jnedbal/MicroFLiC_junction_shield_1_1/MicroFLiC_junction_shield.kicad_pcb

## KiCad design MicroFLiC_junction_shield.kicad_pcb (2016-07-07)

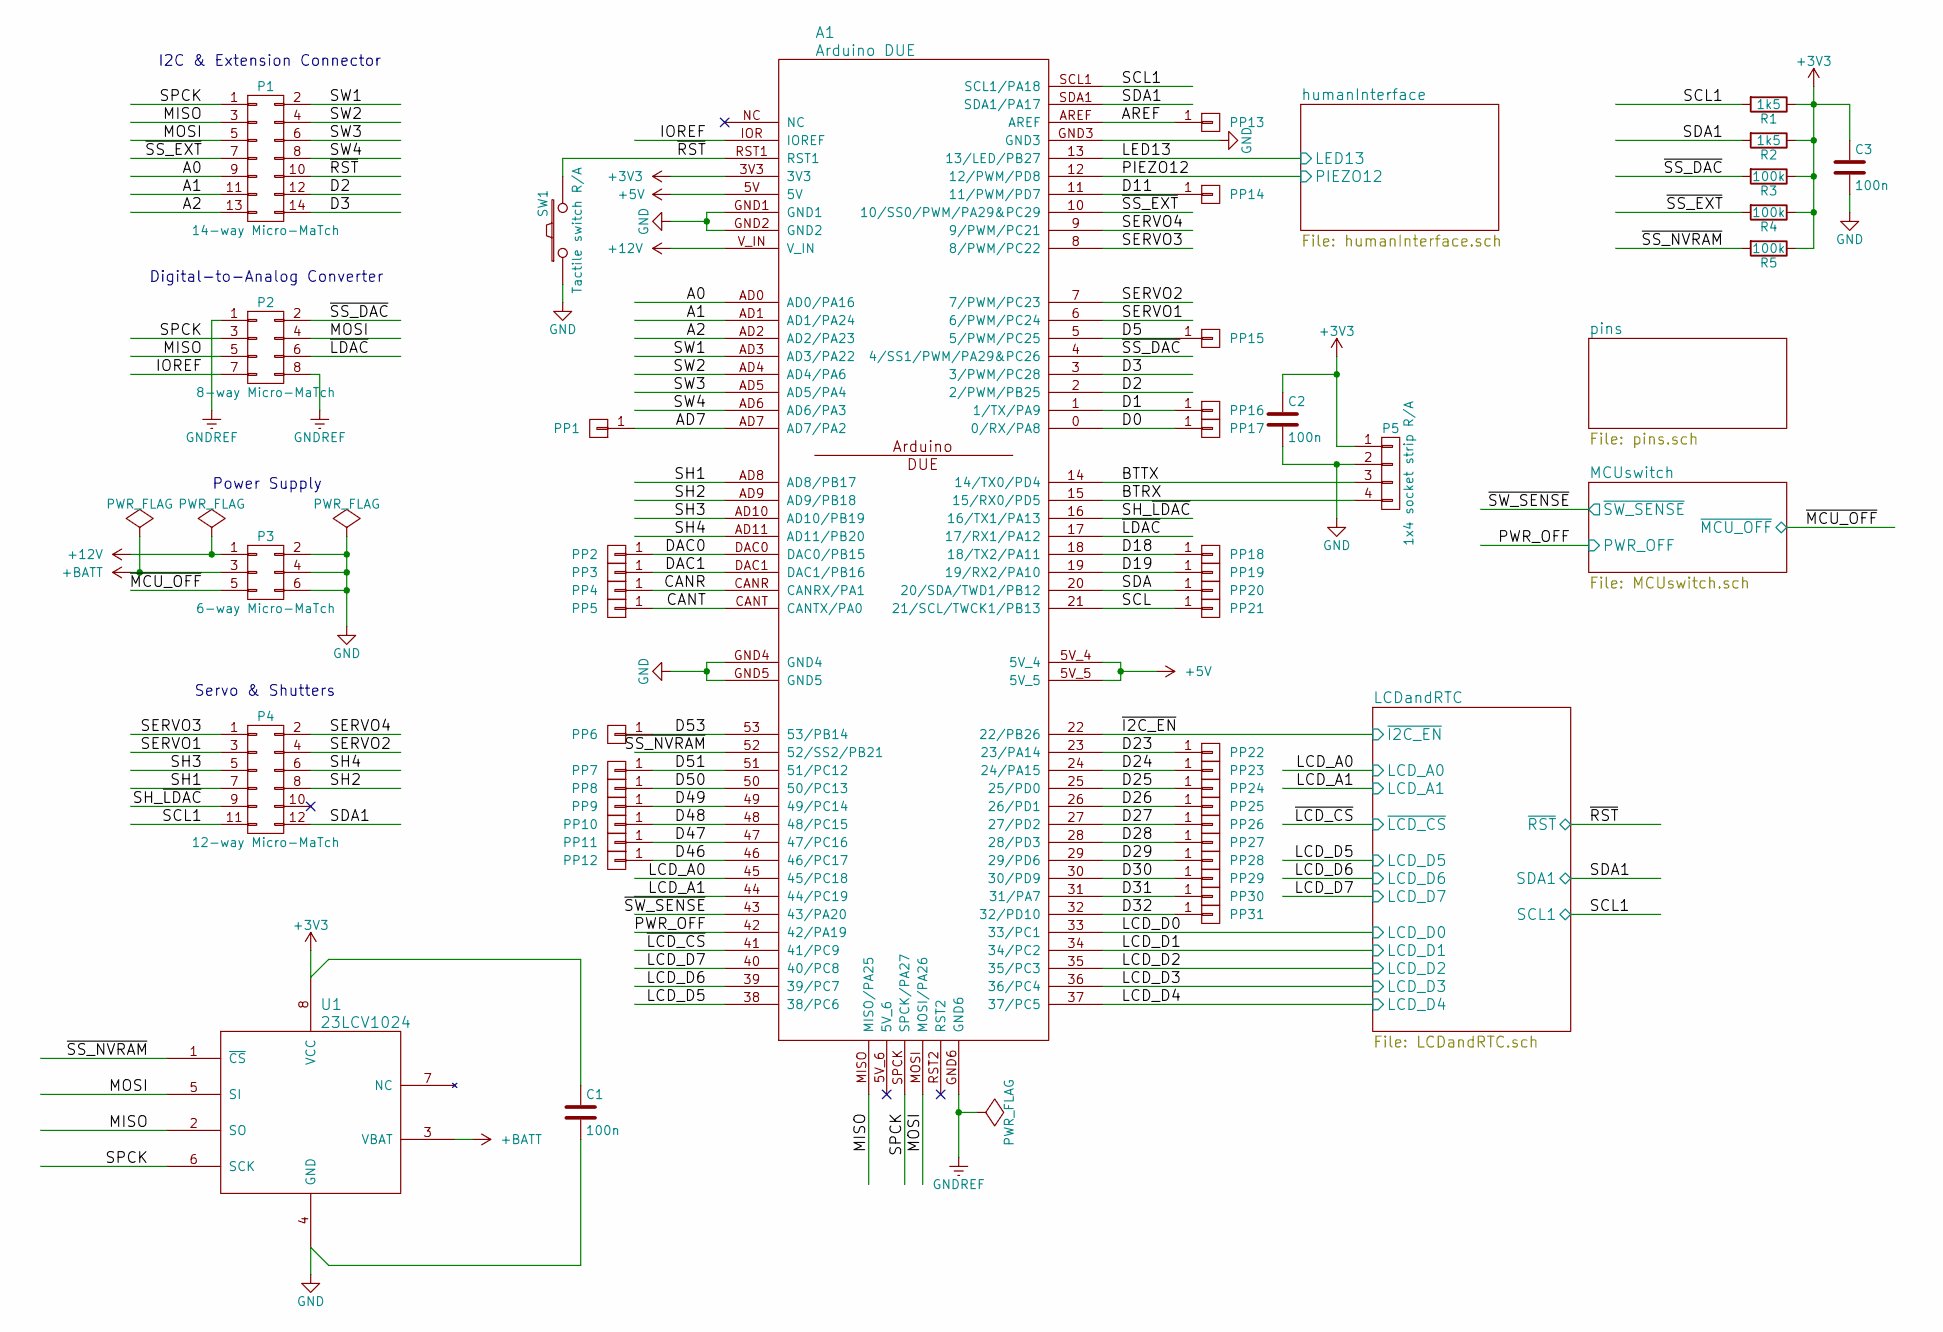
[picture p1: schematic MicroFLiC_junction_shield.sch, MicroFLiC junction shield]

Parts:
A1: Arduino DUE; ARDUINO_DUE; Part Number A000062
C1, C2, C3: 100n; C_0805; Part Number MC0805B104K250CT
P1: 14-way Micro-MaTch; 1-188275-4; Part Number 8-188275-4
P2: 8-way Micro-MaTch; 7-188275-8; Part Number 7-188275-8
P3: 6-way Micro-MaTch; 7-188275-6; Part Number 7-188275-6
P4: 12-way Micro-MaTch; 1-188275-2; Part Number 8-188275-2
P5: 1x4 socket strip R/A; Socket_Strip_Straight_1x04; Part Number SSW-104-02-G-S-RA
PP1, PP2, PP3, PP4, PP5, PP6, PP7, PP8, PP9, PP10, PP11, PP12, PP13, PP14, PP15, PP16, PP17, PP18, PP19, PP20, PP21, PP22, PP23, PP24, PP25, PP26, PP27, PP28, PP29, PP30, PP31: CONN_01X01; PIN_ARRAY_1
R1, R2: 1k5; R_0805; Part Number MCWR08X1501FTL
R3, R4, R5: 100k; R_0805; Part Number MCWR08X1003FTL
SW1: Tactile switch R/A; tactileSwitchRA; Part Number MCDTSA6-5N
U1: 23LCV1024; SOIC-8_3.9x4.9mm_Pitch1.27mm; Part Number 23LCV1024-I/SN

Connections:
+3V3: A1.3V3, C1.1, C2.1, C3.1, P5.1, R1.1, R2.1, R3.1, R4.1, R5.1, U1.8 (VCC); also elsewhere on the board
+5V: A1.5V, A1.5V_4, A1.5V_5; also elsewhere on the board
+12V: A1.V_IN, P3.1; also elsewhere on the board
+BATT: P3.3, U1.3 (VBAT); also elsewhere on the board
/A0: A1.AD0 (AD0/PA16), P1.9
/A1: A1.AD1 (AD1/PA24), P1.11
/A2: A1.AD2 (AD2/PA23), P1.13
/AD7: A1.AD7 (AD7/PA2), PP1.1
/AREF: A1.AREF, PP13.1
/BTRX: A1.15 (15/RX0/PD5), P5.4
/BTTX: A1.14 (14/TX0/PD4), P5.3
/CANR: A1.CANR (CANRX/PA1), PP4.1
/CANT: A1.CANT (CANTX/PA0), PP5.1
/D0: A1.0 (0/RX/PA8), PP17.1
/D1: A1.1 (1/TX/PA9), PP16.1
/D2: A1.2 (2/PWM/PB25), P1.12
/D3: A1.3 (3/PWM/PC28), P1.14
/D5: A1.5 (5/PWM/PC25), PP15.1
/D11: A1.11 (11/PWM/PD7), PP14.1
/D18: A1.18 (18/TX2/PA11), PP18.1
/D19: A1.19 (19/RX2/PA10), PP19.1
/D23: A1.23 (23/PA14), PP22.1
/D24: A1.24 (24/PA15), PP23.1
/D25: A1.25 (25/PD0), PP24.1
/D26: A1.26 (26/PD1), PP25.1
/D27: A1.27 (27/PD2), PP26.1
/D28: A1.28 (28/PD3), PP27.1
/D29: A1.29 (29/PD6), PP28.1
/D30: A1.30 (30/PD9), PP29.1
/D31: A1.31 (31/PA7), PP30.1
/D32: A1.32 (32/PD10), PP31.1
/D46: A1.46 (46/PC17), PP12.1
/D47: A1.47 (47/PC16), PP11.1
/D48: A1.48 (48/PC15), PP10.1
/D49: A1.49 (49/PC14), PP9.1
/D50: A1.50 (50/PC13), PP8.1
/D51: A1.51 (51/PC12), PP7.1
/D53: A1.53 (53/PB14), PP6.1
/DAC0: A1.DAC0 (DAC0/PB15), PP2.1
/DAC1: A1.DAC1 (DAC1/PB16), PP3.1
/IOREF: A1.IOR (IOREF), P2.7
/LCDandRTC/LCD_A0: A1.45 (45/PC18); also elsewhere on the board
/LCDandRTC/LCD_A1: A1.44 (44/PC19); also elsewhere on the board
/LCDandRTC/LCD_D0: A1.33 (33/PC1); also elsewhere on the board
/LCDandRTC/LCD_D1: A1.34 (34/PC2); also elsewhere on the board
/LCDandRTC/LCD_D2: A1.35 (35/PC3); also elsewhere on the board
/LCDandRTC/LCD_D3: A1.36 (36/PC4); also elsewhere on the board
/LCDandRTC/LCD_D4: A1.37 (37/PC5); also elsewhere on the board
/LCDandRTC/LCD_D5: A1.38 (38/PC6); also elsewhere on the board
/LCDandRTC/LCD_D6: A1.39 (39/PC7); also elsewhere on the board
/LCDandRTC/LCD_D7: A1.40 (40/PC8); also elsewhere on the board
/LCDandRTC/SCL1: A1.SCL1 (SCL1/PA18), P4.11, R1.2; also elsewhere on the board
/LCDandRTC/SDA1: A1.SDA1 (SDA1/PA17), P4.12, R2.2; also elsewhere on the board
/LCDandRTC/~I2C_EN: A1.22 (22/PB26); also elsewhere on the board
/LCDandRTC/~LCD_CS: A1.41 (41/PC9); also elsewhere on the board
/LCDandRTC/~RST: A1.RST1, P1.10, SW1.2; also elsewhere on the board
/MCUswitch/PWR_OFF: A1.42 (42/PA19); also elsewhere on the board
/MCUswitch/~MCU_OFF: P3.5; also elsewhere on the board
/MCUswitch/~SW_SENSE: A1.43 (43/PA20); also elsewhere on the board
/MISO: A1.MISO (MISO/PA25), P1.3, P2.5, U1.2 (SO)
/MOSI: A1.MOSI (MOSI/PA26), P1.5, P2.4, U1.5 (SI)
/SCL: A1.21 (21/SCL/TWCK1/PB13), PP21.1
/SDA: A1.20 (20/SDA/TWD1/PB12), PP20.1
/SERVO1: A1.6 (6/PWM/PC24), P4.3
/SERVO2: A1.7 (7/PWM/PC23), P4.4
/SERVO3: A1.8 (8/PWM/PC22), P4.1
/SERVO4: A1.9 (9/PWM/PC21), P4.2
/SH1: A1.AD8 (AD8/PB17), P4.7
/SH2: A1.AD9 (AD9/PB18), P4.8
/SH3: A1.AD10 (AD10/PB19), P4.5
/SH4: A1.AD11 (AD11/PB20), P4.6
/SH_~LDAC: A1.16 (16/TX1/PA13), P4.9
/SPCK: A1.SPCK (SPCK/PA27), P1.1, P2.3, U1.6 (SCK)
/SW1: A1.AD3 (AD3/PA22), P1.2
/SW2: A1.AD4 (AD4/PA6), P1.4
/SW3: A1.AD5 (AD5/PA4), P1.6
/SW4: A1.AD6 (AD6/PA3), P1.8
/humanInterface/LED13: A1.13 (13/LED/PB27); also elsewhere on the board
/humanInterface/PIEZO12: A1.12 (12/PWM/PD8); also elsewhere on the board
/~LDAC: A1.17 (17/RX1/PA12), P2.6
/~SS_DAC: A1.4 (4/SS1/PWM/PA29&PC26), P2.2, R3.2
/~SS_EXT: A1.10 (10/SS0/PWM/PA29&PC29), P1.7, R4.2
/~SS_NVRAM: A1.52 (52/SS2/PB21), R5.2, U1.1 (~CS)
GND: A1.GND1, A1.GND2, A1.GND3, A1.GND4, A1.GND5, C1.2, C2.2, C3.2, P3.2, P3.4, P3.6, P5.2, SW1.1, U1.4 (GND); also elsewhere on the board
GNDREF: A1.GND6, P2.1, P2.8

Notes on the sheet:
I2C & Extension Connector
Digital-to-Analog Converter
Power Supply
Servo & Shutters

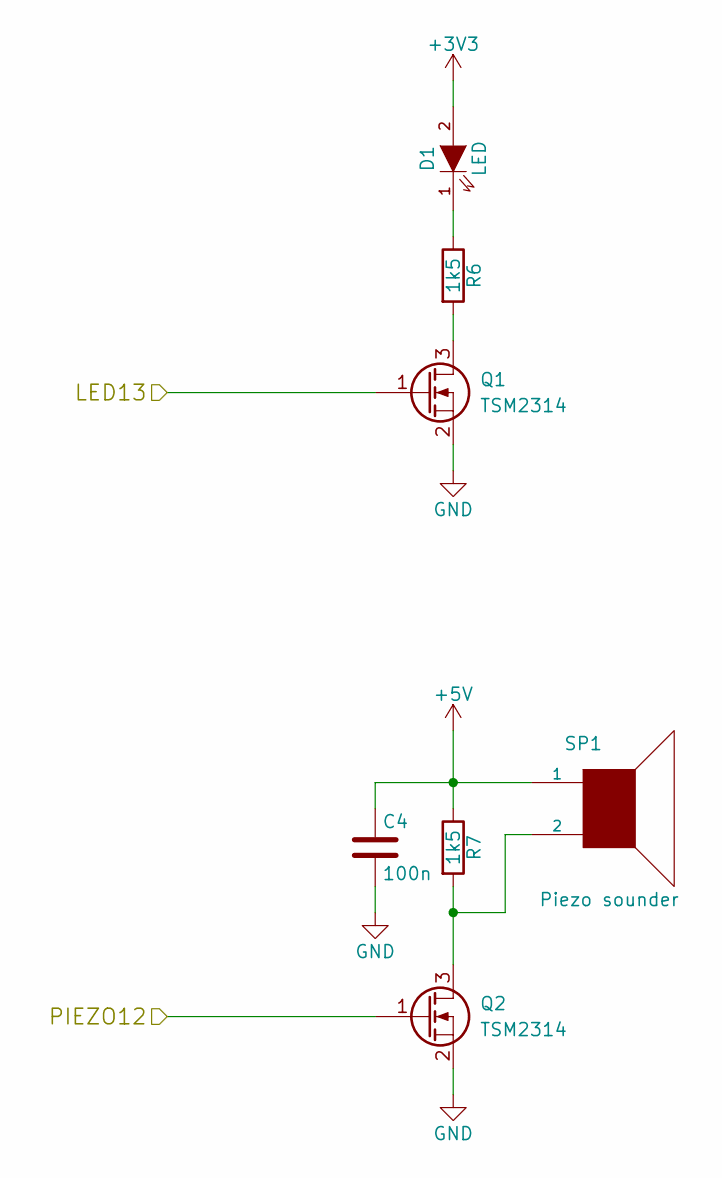
[picture p2: schematic humanInterface.sch]

Parts:
C4: 100n; C_0805; Part Number MC0805B104K250CT
D1: LED; LED-1206; Part Number HSMY-C150
Q1, Q2: TSM2314; SOT-23; Part Number TSM2314CX
R6, R7: 1k5; R_0805; Part Number MCWR08X1501FTL
SP1: Piezo sounder; piezo; Part Number PKM13EPYH4000-A0

Connections:
+3V3: D1.2 (A); also elsewhere on the board
+5V: C4.1, R7.1, SP1.1; also elsewhere on the board
/humanInterface/LED13: Q1.1 (G); also elsewhere on the board
/humanInterface/PIEZO12: Q2.1 (G); also elsewhere on the board
GND: C4.2, Q1.2 (S), Q2.2 (S); also elsewhere on the board
unnamed: D1.1 (K), R6.1
unnamed: Q1.3 (D), R6.2
unnamed: Q2.3 (D), R7.2, SP1.2

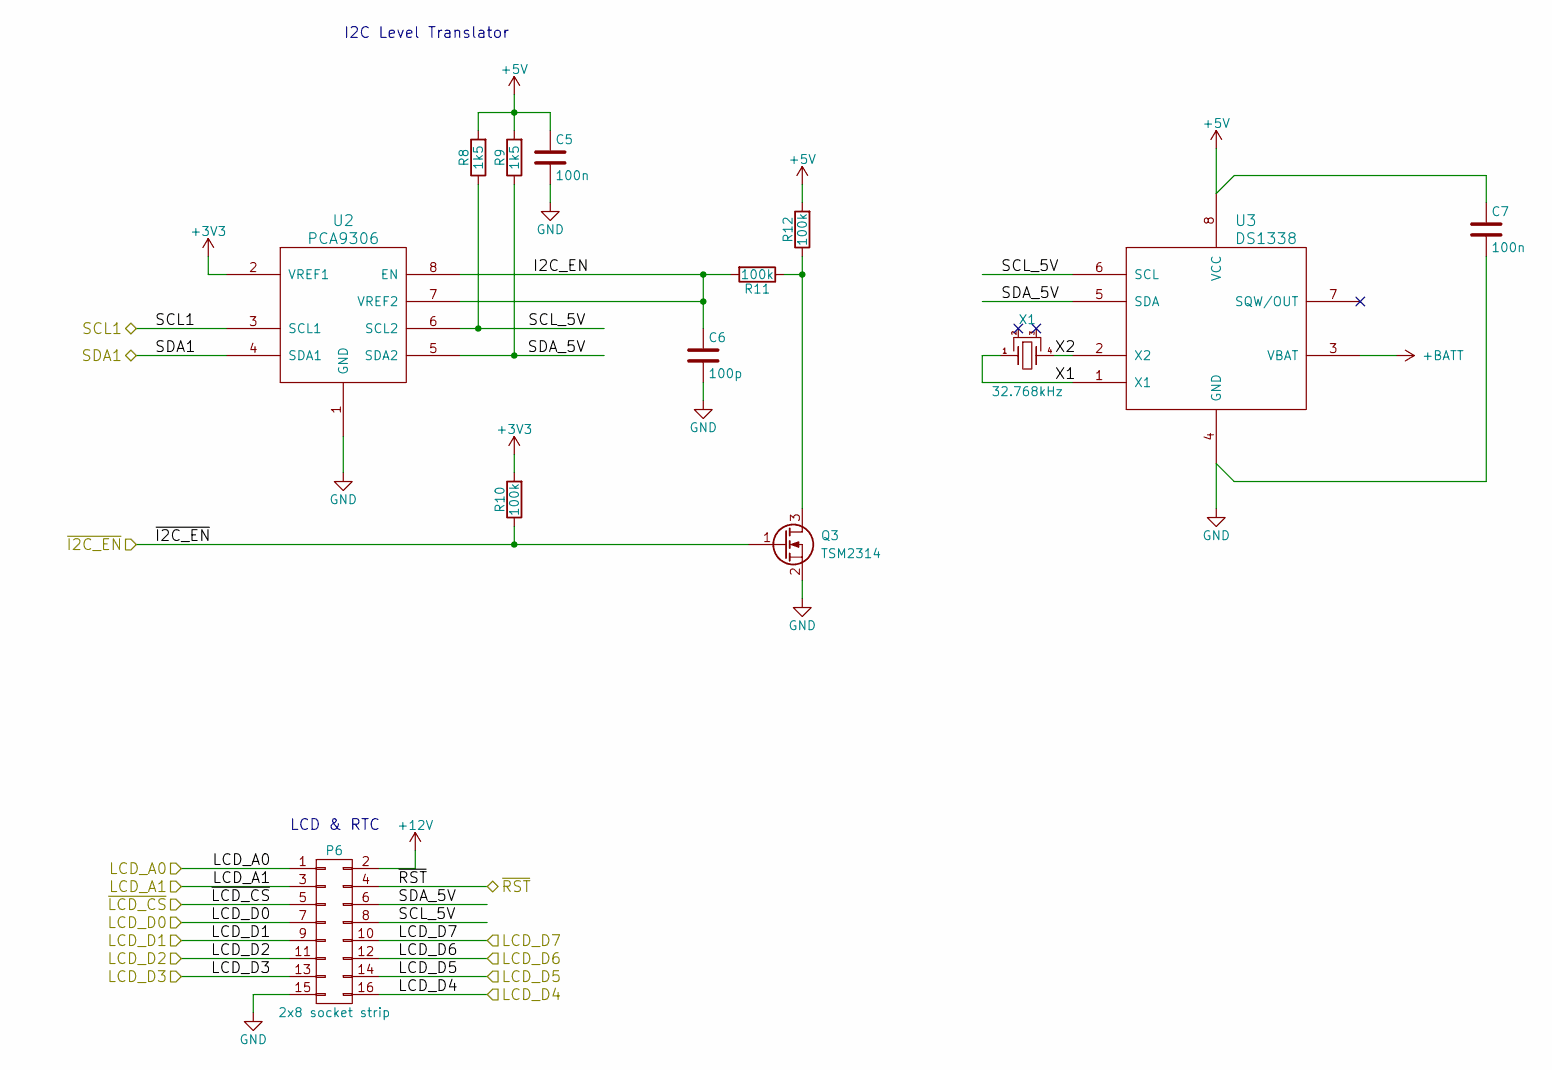
[picture p3: schematic LCDandRTC.sch]

Parts:
C5, C7: 100n; C_0805; Part Number MC0805B104K250CT
C6: 100p; C_0805; Part Number CGA4C2C0G2A101J060AA
P6: 2x8 socket strip; Socket_Strip_Straight_2x08; Part Number ESQ-108-33-G-D
Q3: TSM2314; SOT-23; Part Number TSM2314CX
R8, R9: 1k5; R_0805; Part Number MCWR08X1501FTL
R10, R11, R12: 100k; R_0805; Part Number MCWR08X1003FTL
U2: PCA9306; MSOP-8_3x3mm_Pitch0.65mm; Part Number PCA9306DP
U3: DS1338; SOIC-8_3.9x4.9mm_Pitch1.27mm; Part Number DS1338Z-33
X1: 32.768kHz; Crystal_8.7*3.7mm; Part Number FSRLF327

Connections:
+3V3: R10.2, U2.2 (VREF1); also elsewhere on the board
+5V: C5.1, C7.1, R8.2, R9.2, R12.2, U3.8 (VCC); also elsewhere on the board
+12V: P6.2; also elsewhere on the board
+BATT: U3.3 (VBAT); also elsewhere on the board
/LCDandRTC/I2C_EN: C6.1, R11.2, U2.7 (VREF2), U2.8 (EN)
/LCDandRTC/LCD_A0: P6.1; also elsewhere on the board
/LCDandRTC/LCD_A1: P6.3; also elsewhere on the board
/LCDandRTC/LCD_D0: P6.7; also elsewhere on the board
/LCDandRTC/LCD_D1: P6.9; also elsewhere on the board
/LCDandRTC/LCD_D2: P6.11; also elsewhere on the board
/LCDandRTC/LCD_D3: P6.13; also elsewhere on the board
/LCDandRTC/LCD_D4: P6.16; also elsewhere on the board
/LCDandRTC/LCD_D5: P6.14; also elsewhere on the board
/LCDandRTC/LCD_D6: P6.12; also elsewhere on the board
/LCDandRTC/LCD_D7: P6.10; also elsewhere on the board
/LCDandRTC/SCL1: U2.3 (SCL1); also elsewhere on the board
/LCDandRTC/SCL_5V: P6.8, R8.1, U2.6 (SCL2), U3.6 (SCL)
/LCDandRTC/SDA1: U2.4 (SDA1); also elsewhere on the board
/LCDandRTC/SDA_5V: P6.6, R9.1, U2.5 (SDA2), U3.5 (SDA)
/LCDandRTC/X1: U3.1 (X1), X1.1 (A)
/LCDandRTC/X2: U3.2 (X2), X1.4 (B)
/LCDandRTC/~I2C_EN: Q3.1 (G), R10.1; also elsewhere on the board
/LCDandRTC/~LCD_CS: P6.5; also elsewhere on the board
/LCDandRTC/~RST: P6.4; also elsewhere on the board
GND: C5.2, C6.2, C7.2, P6.15, Q3.2 (S), U2.1 (GND), U3.4 (GND); also elsewhere on the board
unnamed: Q3.3 (D), R11.1, R12.1

Notes on the sheet:
I2C Level Translator
LCD & RTC

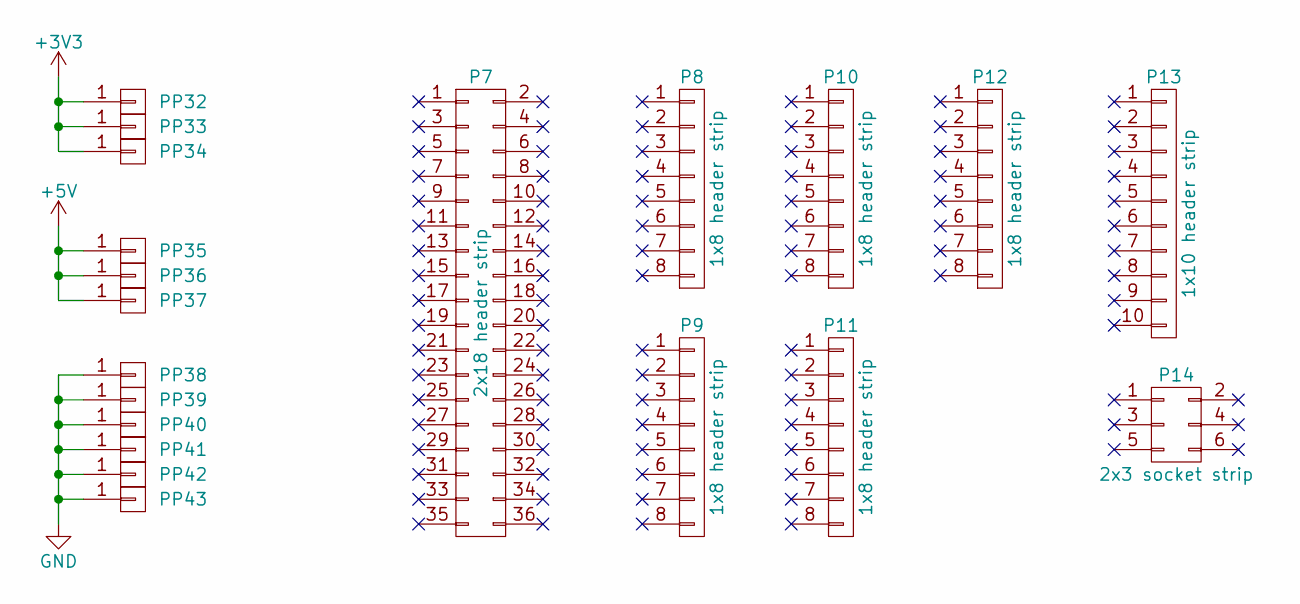
[picture p4: schematic pins.sch]

Parts:
P7: 2x18 header strip; Part Number 61303621121
P8, P9, P10, P11, P12: 1x8 header strip; Part Number M20-9990845
P13: 1x10 header strip; Part Number M20-9991046
P14: 2x3 socket strip; Part Number M20-7830346
PP32, PP33, PP34, PP35, PP36, PP37, PP38, PP39, PP40, PP41, PP42, PP43: CONN_01X01; PIN_ARRAY_1

Connections:
+3V3: PP32.1, PP33.1, PP34.1; also elsewhere on the board
+5V: PP35.1, PP36.1, PP37.1; also elsewhere on the board
GND: PP38.1, PP39.1, PP40.1, PP41.1, PP42.1, PP43.1; also elsewhere on the board

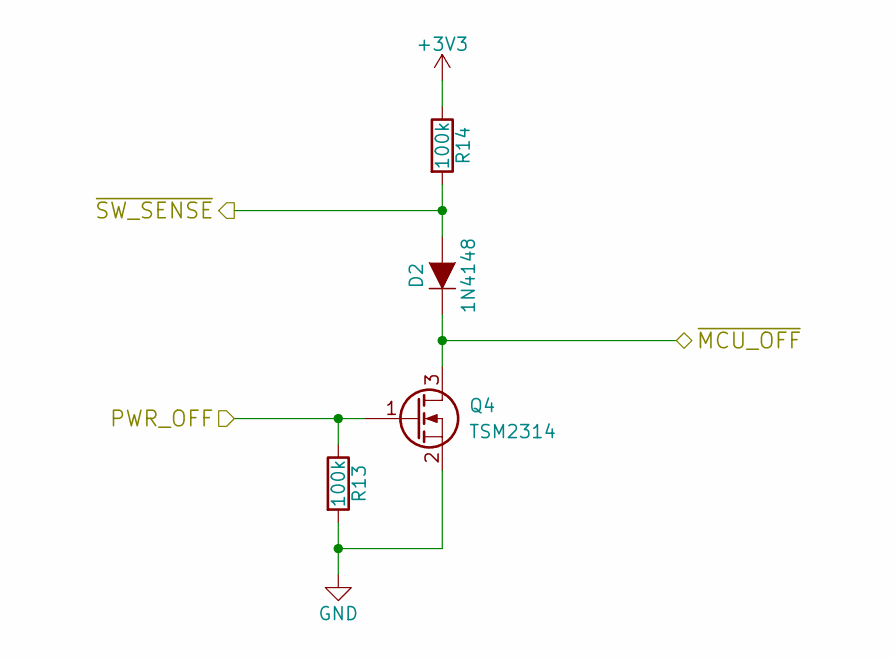
[picture p5: schematic MCUswitch.sch]

Parts:
D2: 1N4148; SOD-323; Part Number 1N4148WS
Q4: TSM2314; SOT-23; Part Number TSM2314CX
R13, R14: 100k; R_0805; Part Number MCWR08X1003FTL

Connections:
+3V3: R14.1; also elsewhere on the board
/MCUswitch/PWR_OFF: Q4.1 (G), R13.1; also elsewhere on the board
/MCUswitch/~MCU_OFF: D2.1 (K), Q4.3 (D); also elsewhere on the board
/MCUswitch/~SW_SENSE: D2.2 (A), R14.2; also elsewhere on the board
GND: Q4.2 (S), R13.2; also elsewhere on the board

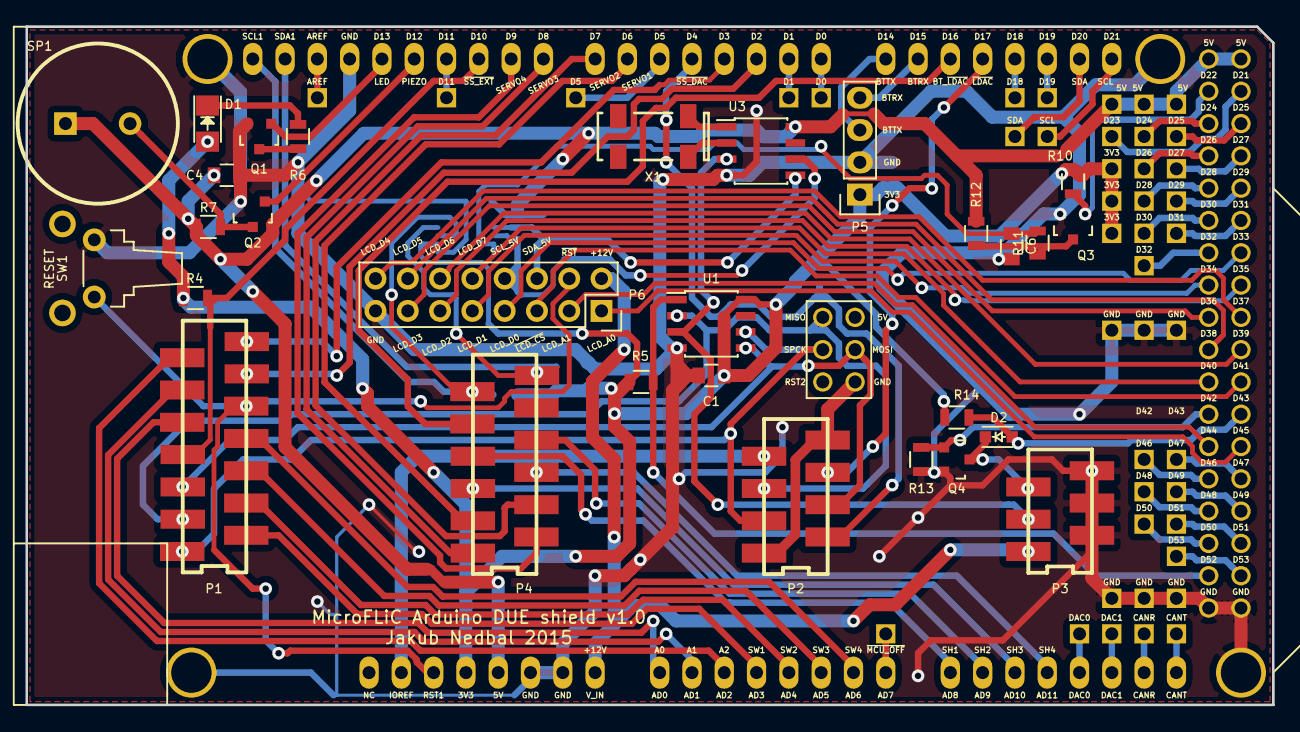
[picture p6: board MicroFLiC_junction_shield.kicad_pcb from above]

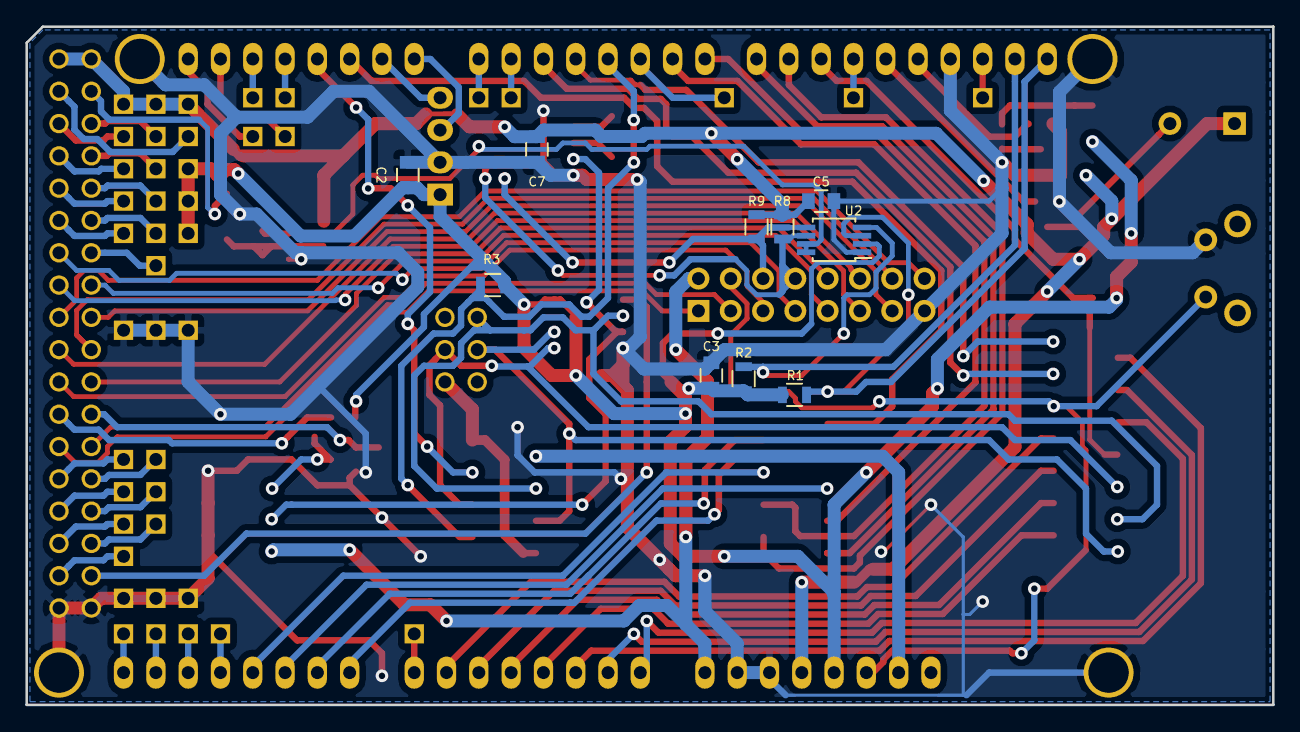
[picture p7: board MicroFLiC_junction_shield.kicad_pcb from below]

Board: 2 copper layers, 98.0 x 53.3 mm, 83 parts (10 on the bottom side), 94 nets.
