jnedbal/MicroFLiC_junction_shield_1_1/(commit log)

2016-01-06 First commit and final production board v1.0
    [LCDandRTC.sch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]
2016-02-14 Last commit in v1.0
    [LCDandRTC.sch, MicroFLiC_junction_shield_1_0.csv, MicroFLiC_junction_shield_1_0.sch, humanInterface.sch]
2016-02-14 First commit of version 1.1
    [MicroFLiC_junction_shield.csv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]
2016-02-15 Started fully describing components
    [LCDandRTC.sch, MicroFLiC_junction_shield.csv, MicroFLiC_junction_shield.sch, humanInterface.sch, pins.sch]
2016-02-24 Added MCU power control (MCUswitch.sch)
    [LCDandRTC.sch, MCUswitch.sch, MicroFLiC_junction_shield.kicad_pcb, MicroFLiC_junction_shield.sch, humanInterface.sch, pins.sch]
2016-02-25 Updated PCB for MCU switch, fixed SPCK connection, added correct angled connector for BT
    [MicroFLiC_junction_shield.kicad_pcb]
2016-02-25 Finished adding full part descriptions
    [LCDandRTC.sch, MCUswitch.sch, MicroFLiC_junction_shield.csv, MicroFLiC_junction_shield.sch, humanInterface.sch, pins.sch]
2016-02-29 Changed 3D drawing to include ESQ connector for LCD
    [MicroFLiC_junction_shield.kicad_pcb]
2016-03-02 Changed part number or yellow LED
    [MicroFLiC_junction_shield.csv, MicroFLiC_junction_shield.kicad_pcb, humanInterface.sch]
2016-03-02 Incorporated un-pulled changes
    [LCDandRTC.sch, MicroFLiC_junction_shield.sch, humanInterface.sch, pins.sch]
2016-03-18 Changed SHIELD1 to A1, changed SOD-323 footprint for easier soldering
    [MCUswitch.sch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]
2016-03-18 Changed layout of I2C buffer enabling
    [LCDandRTC.sch, MCUswitch.sch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]
2016-07-06 Fixed crossed-over SCL and SDA lines
    [LCDandRTC.sch, MCUswitch.sch, MicroFLiC_junction_shield.sch, humanInterface.sch, pins.sch]
2016-07-07 Changed LCD shield from Wire to Wire1
    [LCDandRTC.sch, MCUswitch.sch, MicroFLiC_junction_shield.kicad_pcb, MicroFLiC_junction_shield.sch, humanInterface.sch, pins.sch]
2016-07-07 Tidied up few routes
    [MicroFLiC_junction_shield.kicad_pcb]
